prestofuoco/falling-sand/pcb/falling-sand.kicad_pcb

## KiCad design pcb/falling-sand.kicad_pcb (2026-03-06)

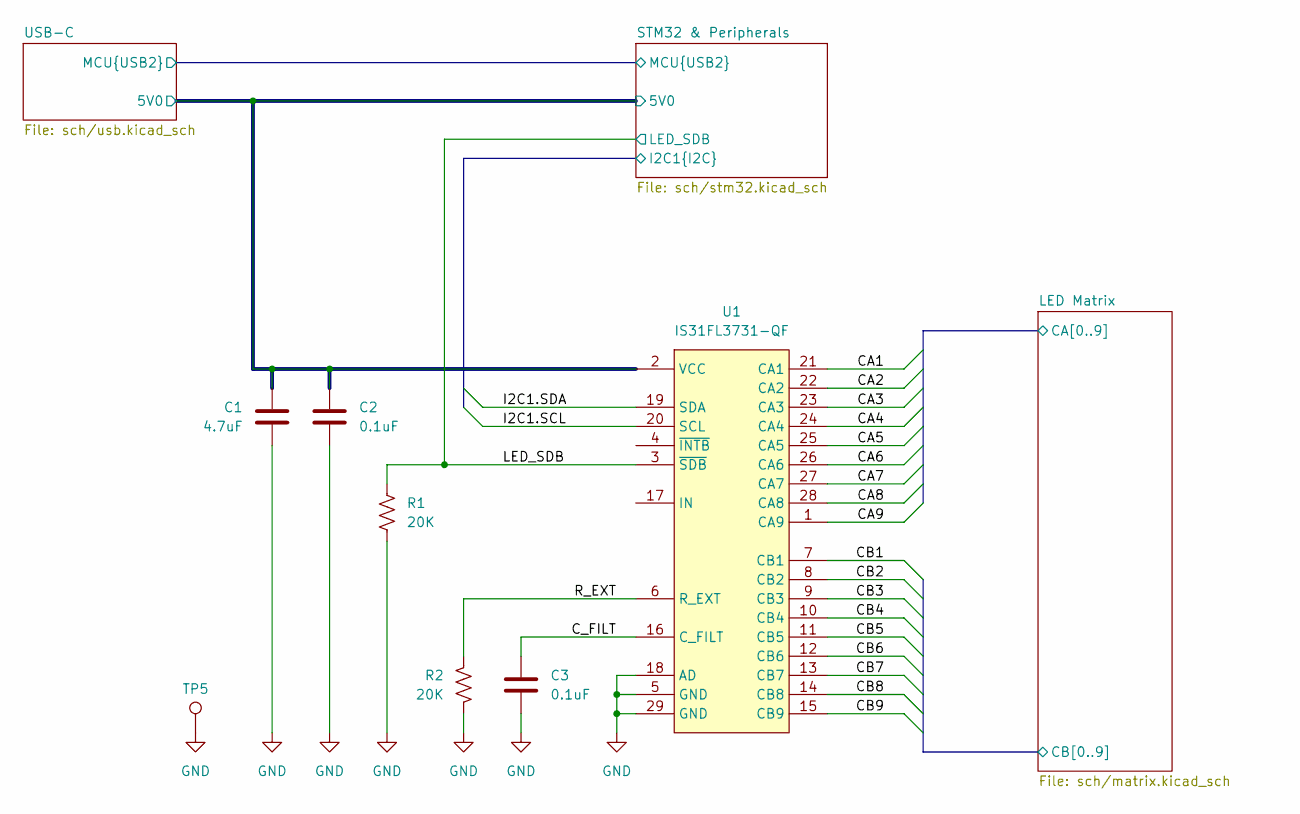
[picture p1: schematic falling-sand.kicad_sch]

Parts:
C1: 4.7uF; C_0603_1608Metric
C2, C3: 0.1uF; C_0402_1005Metric
R1, R2: 20K; R_0402_1005Metric
TP5: TestPoint; TestPoint_Pad_D1.0mm
U1: IS31FL3731-QF; QFN-28-1EP_4x4mm_P0.4mm_EP2.4x2.4mm

Connections:
/C_FILT: C3.1, U1.16 (C_FILT)
/LED Matrix/CA1: U1.21 (CA1); also elsewhere on the board
/LED Matrix/CA2: U1.22 (CA2); also elsewhere on the board
/LED Matrix/CA3: U1.23 (CA3); also elsewhere on the board
/LED Matrix/CA4: U1.24 (CA4); also elsewhere on the board
/LED Matrix/CA5: U1.25 (CA5); also elsewhere on the board
/LED Matrix/CA6: U1.26 (CA6); also elsewhere on the board
/LED Matrix/CA7: U1.27 (CA7); also elsewhere on the board
/LED Matrix/CA8: U1.28 (CA8); also elsewhere on the board
/LED Matrix/CA9: U1.1 (CA9); also elsewhere on the board
/LED Matrix/CB1: U1.7 (CB1); also elsewhere on the board
/LED Matrix/CB2: U1.8 (CB2); also elsewhere on the board
/LED Matrix/CB3: U1.9 (CB3); also elsewhere on the board
/LED Matrix/CB4: U1.10 (CB4); also elsewhere on the board
/LED Matrix/CB5: U1.11 (CB5); also elsewhere on the board
/LED Matrix/CB6: U1.12 (CB6); also elsewhere on the board
/LED Matrix/CB7: U1.13 (CB7); also elsewhere on the board
/LED Matrix/CB8: U1.14 (CB8); also elsewhere on the board
/LED Matrix/CB9: U1.15 (CB9); also elsewhere on the board
/LED_SDB: R1.1, U1.3 (~SDB); also elsewhere on the board
/R_EXT: R2.1, U1.6 (R_EXT)
/STM32 & Peripherals/5V0: C1.1, C2.1, U1.2 (VCC); also elsewhere on the board
/STM32 & Peripherals/I2C1.SCL: U1.20 (SCL); also elsewhere on the board
/STM32 & Peripherals/I2C1.SDA: U1.19 (SDA); also elsewhere on the board
GND: C1.2, C2.2, C3.2, R1.2, R2.2, TP5.1 (1_1), U1.5 (GND), U1.18 (AD), U1.29 (GND); also elsewhere on the board

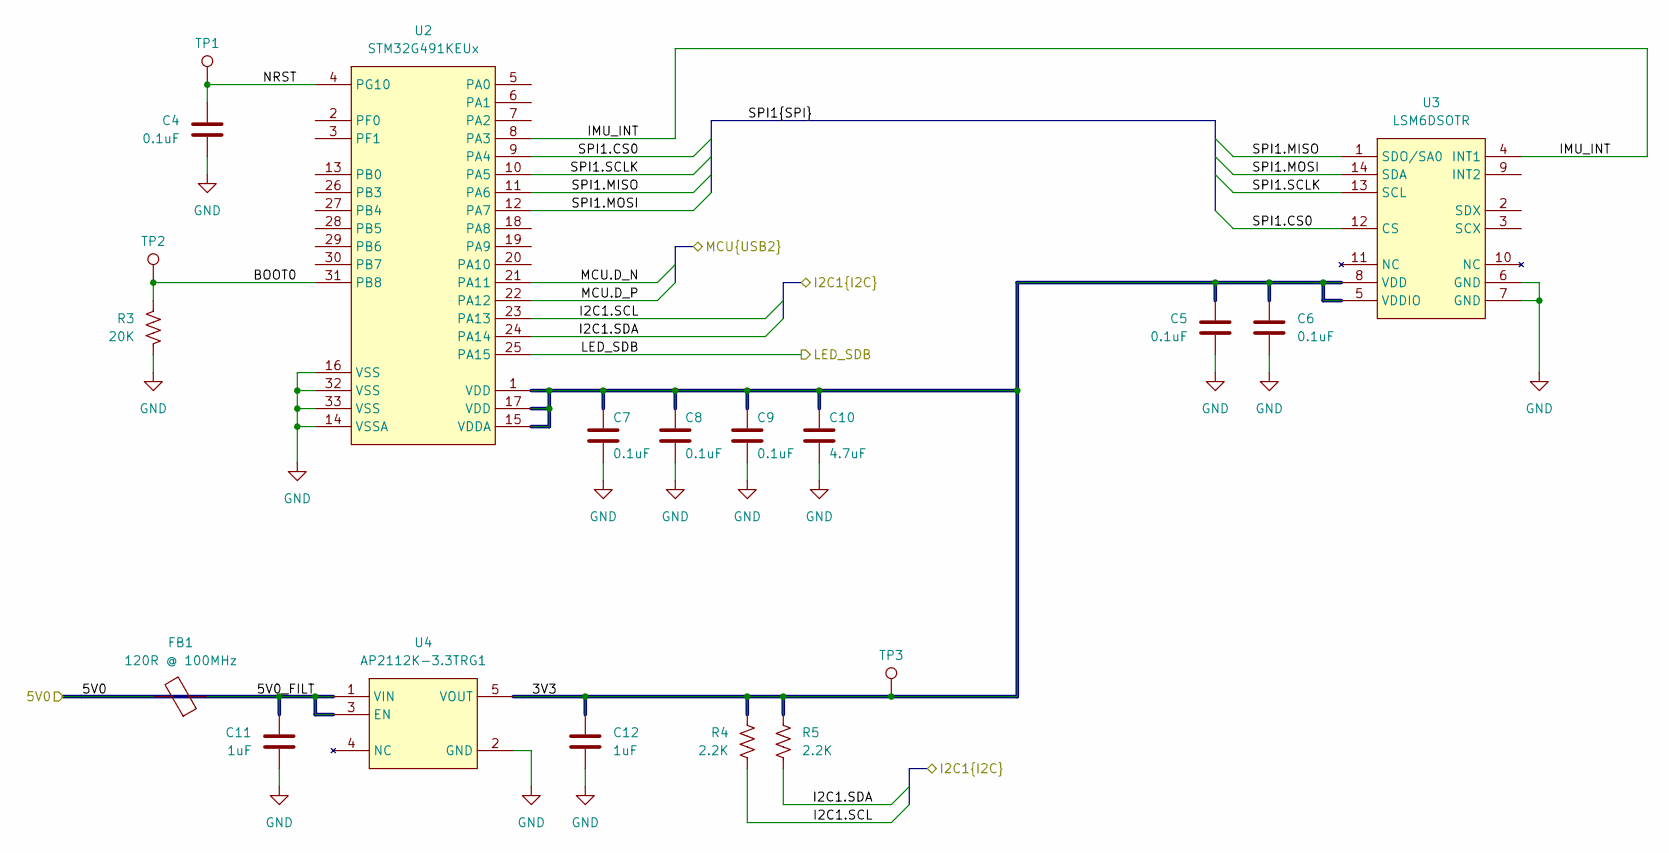
[picture p2: schematic stm32.kicad_sch]

Parts:
C4, C5, C6, C7, C8, C9: 0.1uF; C_0402_1005Metric
C10: 4.7uF; C_0603_1608Metric
C11, C12: 1uF; C_0603_1608Metric
FB1: 120R @ 100MHz; L_0805_2012Metric
R3: 20K; R_0402_1005Metric
R4, R5: 2.2K; R_0402_1005Metric
TP1, TP2, TP3: TestPoint; TestPoint_Pad_D1.0mm
U2: STM32G491KEUx; QFN-32-1EP_5x5mm_P0.5mm_EP3.45x3.45mm
U3: LSM6DSOTR; LGA-14_3x2.5mm_P0.5mm_LayoutBorder3x4y
U4: AP2112K-3.3TRG1; SOT-23-5

Connections:
/LED_SDB: U2.25 (PA15); also elsewhere on the board
/STM32 & Peripherals/3V3: C5.1, C6.1, C7.1, C8.1, C9.1, C10.1, C12.1, R4.1, R5.1, TP3.1 (1_1), U2.1 (VDD), U2.15 (VDDA), U2.17 (VDD), U3.5 (VDDIO), U3.8 (VDD), U4.5 (VOUT)
/STM32 & Peripherals/5V0: FB1.2; also elsewhere on the board
/STM32 & Peripherals/5V0_FILT: C11.1, FB1.1, U4.1 (VIN), U4.3 (EN)
/STM32 & Peripherals/BOOT0: R3.1, TP2.1 (1_1), U2.31 (PB8)
/STM32 & Peripherals/I2C1.SCL: R4.2, U2.23 (PA13); also elsewhere on the board
/STM32 & Peripherals/I2C1.SDA: R5.2, U2.24 (PA14); also elsewhere on the board
/STM32 & Peripherals/IMU_INT: U2.8 (PA3), U3.4 (INT1)
/STM32 & Peripherals/MCU.D_N: U2.21 (PA11); also elsewhere on the board
/STM32 & Peripherals/MCU.D_P: U2.22 (PA12); also elsewhere on the board
/STM32 & Peripherals/NRST: C4.1, TP1.1 (1_1), U2.4 (PG10)
/STM32 & Peripherals/SPI1.CS0: U2.9 (PA4), U3.12 (CS)
/STM32 & Peripherals/SPI1.MISO: U2.11 (PA6), U3.1 (SDO/SA0)
/STM32 & Peripherals/SPI1.MOSI: U2.12 (PA7), U3.14 (SDA)
/STM32 & Peripherals/SPI1.SCLK: U2.10 (PA5), U3.13 (SCL)
GND: C4.2, C5.2, C6.2, C7.2, C8.2, C9.2, C10.2, C11.2, C12.2, R3.2, U2.14 (VSSA), U2.16 (VSS), U2.32 (VSS), U2.33 (VSS), U3.6 (GND), U3.7 (GND), U4.2 (GND); also elsewhere on the board

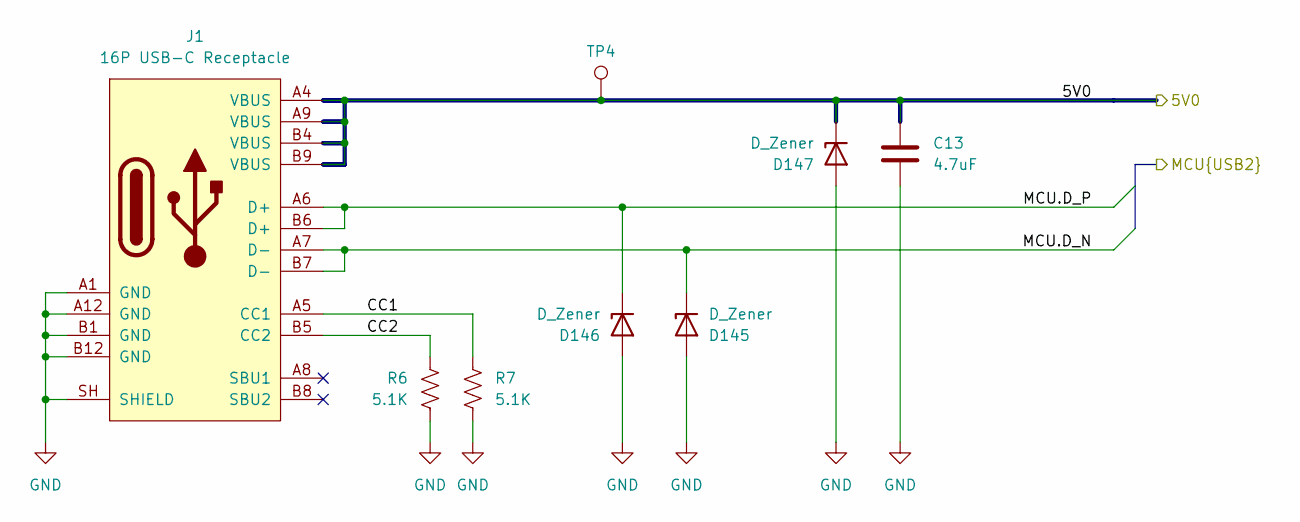
[picture p3: schematic usb.kicad_sch]

Parts:
C13: 4.7uF; C_0603_1608Metric
D145, D146, D147: D_Zener; D_SOD-882
J1: 16P USB-C Receptacle; USB_C_Receptacle_GCT_USB4105-xx-A_16P_TopMnt_Horizontal
R6, R7: 5.1K; R_0402_1005Metric
TP4: TestPoint; TestPoint_Pad_D1.0mm

Connections:
/STM32 & Peripherals/5V0: C13.1, D147.1 (K), J1.A4 (VBUS), J1.A9 (VBUS), J1.B4 (VBUS), J1.B9 (VBUS), TP4.1 (1_1); also elsewhere on the board
/STM32 & Peripherals/MCU.D_N: D145.1 (K), J1.A7 (D-), J1.B7 (D-); also elsewhere on the board
/STM32 & Peripherals/MCU.D_P: D146.1 (K), J1.A6 (D+), J1.B6 (D+); also elsewhere on the board
/USB-C/CC1: J1.A5 (CC1), R7.1
/USB-C/CC2: J1.B5 (CC2), R6.1
GND: C13.2, D145.2 (A), D146.2 (A), D147.2 (A), J1.A1 (GND), J1.A12 (GND), J1.B1 (GND), J1.B12 (GND), J1.SH (SHIELD), R6.2, R7.2; also elsewhere on the board

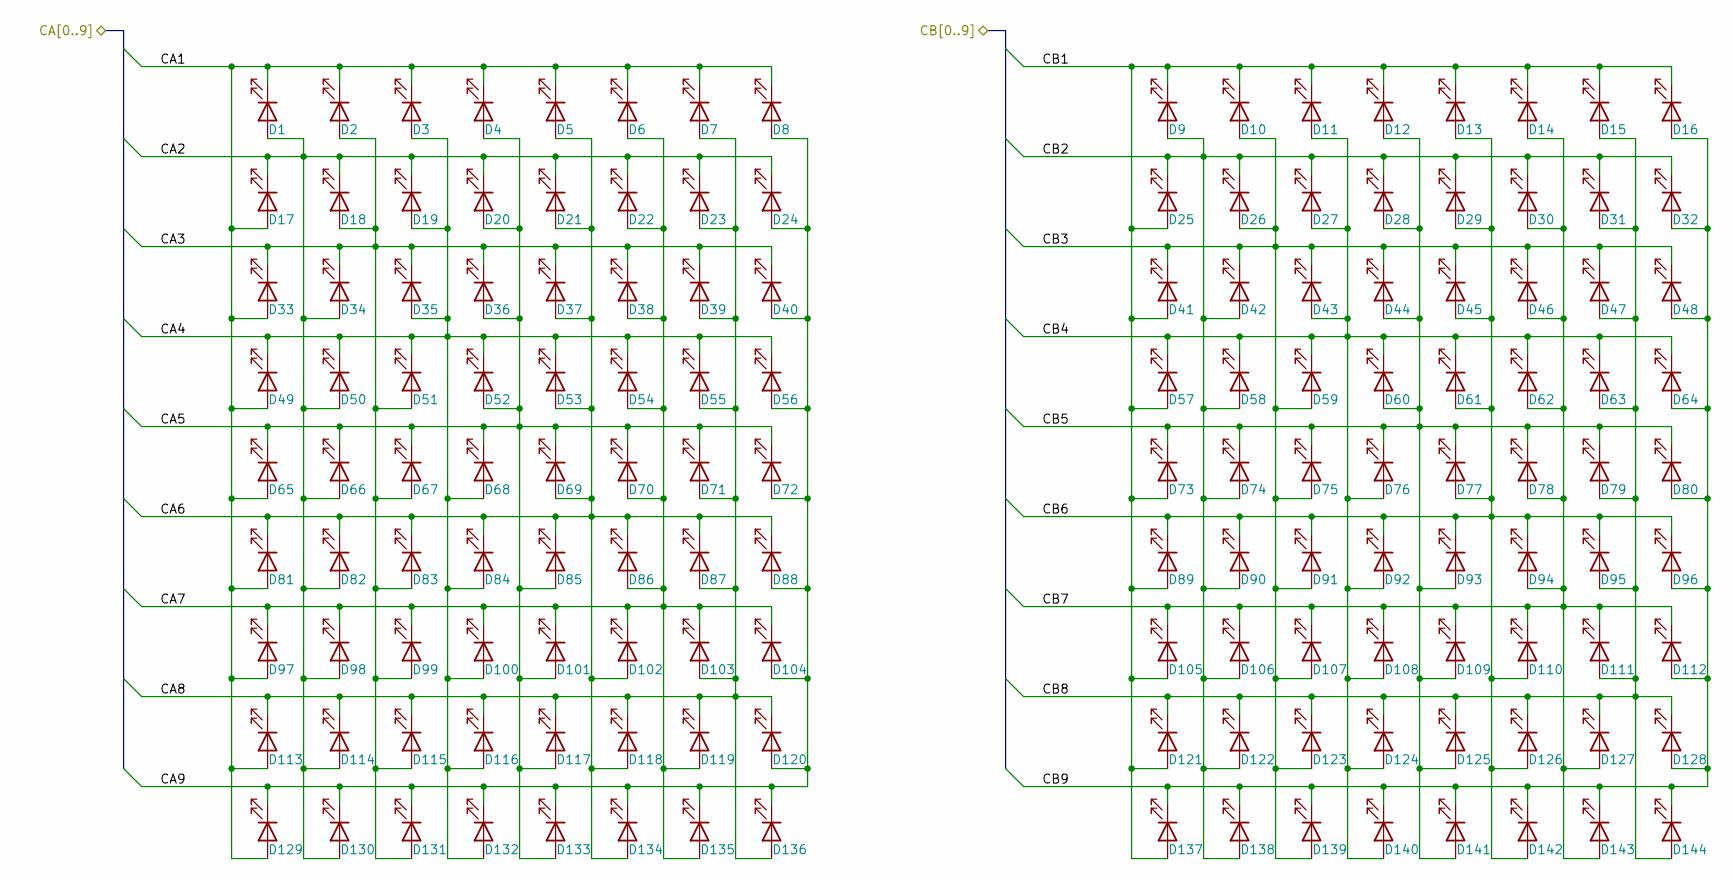
[picture p4: schematic matrix.kicad_sch]

Parts:
D1, D2, D3, D4, D5, D6, D7, D8, D9, D10, D11, D12, D13, D14, D15, D16, D17, D18, D19, D20, D21, D22, D23, D24, D25, D26, D27, D28, D29, D30, D31, D32, D33, D34, D35, D36, D37, D38, D39, D40, D41, D42, D43, D44, D45, D46, D47, D48, D49, D50, D51, D52, D53, D54, D55, D56, D57, D58, D59, D60, D61, D62, D63, D64, D65, D66, D67, D68, D69, D70, D71, D72, D73, D74, D75, D76, D77, D78, D79, D80, D81, D82, D83, D84, D85, D86, D87, D88, D89, D90, D91, D92, D93, D94, D95, D96, D97, D98, D99, D100, D101, D102, D103, D104, D105, D106, D107, D108, D109, D110, D111, D112, D113, D114, D115, D116, D117, D118, D119, D120, D121, D122, D123, D124, D125, D126, D127, D128, D129, D130, D131, D132, D133, D134, D135, D136, D137, D138, D139, D140, D141, D142, D143, D144: LED; LED_0402_1005Metric

Connections:
/LED Matrix/CA1: D1.1 (K), D2.1 (K), D3.1 (K), D4.1 (K), D5.1 (K), D6.1 (K), D7.1 (K), D8.1 (K), D17.2 (A), D33.2 (A), D49.2 (A), D65.2 (A), D81.2 (A), D97.2 (A), D113.2 (A), D129.2 (A); also elsewhere on the board
/LED Matrix/CA2: D1.2 (A), D17.1 (K), D18.1 (K), D19.1 (K), D20.1 (K), D21.1 (K), D22.1 (K), D23.1 (K), D24.1 (K), D34.2 (A), D50.2 (A), D66.2 (A), D82.2 (A), D98.2 (A), D114.2 (A), D130.2 (A); also elsewhere on the board
/LED Matrix/CA3: D2.2 (A), D18.2 (A), D33.1 (K), D34.1 (K), D35.1 (K), D36.1 (K), D37.1 (K), D38.1 (K), D39.1 (K), D40.1 (K), D51.2 (A), D67.2 (A), D83.2 (A), D99.2 (A), D115.2 (A), D131.2 (A); also elsewhere on the board
/LED Matrix/CA4: D3.2 (A), D19.2 (A), D35.2 (A), D49.1 (K), D50.1 (K), D51.1 (K), D52.1 (K), D53.1 (K), D54.1 (K), D55.1 (K), D56.1 (K), D68.2 (A), D84.2 (A), D100.2 (A), D116.2 (A), D132.2 (A); also elsewhere on the board
/LED Matrix/CA5: D4.2 (A), D20.2 (A), D36.2 (A), D52.2 (A), D65.1 (K), D66.1 (K), D67.1 (K), D68.1 (K), D69.1 (K), D70.1 (K), D71.1 (K), D72.1 (K), D85.2 (A), D101.2 (A), D117.2 (A), D133.2 (A); also elsewhere on the board
/LED Matrix/CA6: D5.2 (A), D21.2 (A), D37.2 (A), D53.2 (A), D69.2 (A), D81.1 (K), D82.1 (K), D83.1 (K), D84.1 (K), D85.1 (K), D86.1 (K), D87.1 (K), D88.1 (K), D102.2 (A), D118.2 (A), D134.2 (A); also elsewhere on the board
/LED Matrix/CA7: D6.2 (A), D22.2 (A), D38.2 (A), D54.2 (A), D70.2 (A), D86.2 (A), D97.1 (K), D98.1 (K), D99.1 (K), D100.1 (K), D101.1 (K), D102.1 (K), D103.1 (K), D104.1 (K), D119.2 (A), D135.2 (A); also elsewhere on the board
/LED Matrix/CA8: D7.2 (A), D23.2 (A), D39.2 (A), D55.2 (A), D71.2 (A), D87.2 (A), D103.2 (A), D113.1 (K), D114.1 (K), D115.1 (K), D116.1 (K), D117.1 (K), D118.1 (K), D119.1 (K), D120.1 (K), D136.2 (A); also elsewhere on the board
/LED Matrix/CA9: D8.2 (A), D24.2 (A), D40.2 (A), D56.2 (A), D72.2 (A), D88.2 (A), D104.2 (A), D120.2 (A), D129.1 (K), D130.1 (K), D131.1 (K), D132.1 (K), D133.1 (K), D134.1 (K), D135.1 (K), D136.1 (K); also elsewhere on the board
/LED Matrix/CB1: D9.1 (K), D10.1 (K), D11.1 (K), D12.1 (K), D13.1 (K), D14.1 (K), D15.1 (K), D16.1 (K), D25.2 (A), D41.2 (A), D57.2 (A), D73.2 (A), D89.2 (A), D105.2 (A), D121.2 (A), D137.2 (A); also elsewhere on the board
/LED Matrix/CB2: D9.2 (A), D25.1 (K), D26.1 (K), D27.1 (K), D28.1 (K), D29.1 (K), D30.1 (K), D31.1 (K), D32.1 (K), D42.2 (A), D58.2 (A), D74.2 (A), D90.2 (A), D106.2 (A), D122.2 (A), D138.2 (A); also elsewhere on the board
/LED Matrix/CB3: D10.2 (A), D26.2 (A), D41.1 (K), D42.1 (K), D43.1 (K), D44.1 (K), D45.1 (K), D46.1 (K), D47.1 (K), D48.1 (K), D59.2 (A), D75.2 (A), D91.2 (A), D107.2 (A), D123.2 (A), D139.2 (A); also elsewhere on the board
/LED Matrix/CB4: D11.2 (A), D27.2 (A), D43.2 (A), D57.1 (K), D58.1 (K), D59.1 (K), D60.1 (K), D61.1 (K), D62.1 (K), D63.1 (K), D64.1 (K), D76.2 (A), D92.2 (A), D108.2 (A), D124.2 (A), D140.2 (A); also elsewhere on the board
/LED Matrix/CB5: D12.2 (A), D28.2 (A), D44.2 (A), D60.2 (A), D73.1 (K), D74.1 (K), D75.1 (K), D76.1 (K), D77.1 (K), D78.1 (K), D79.1 (K), D80.1 (K), D93.2 (A), D109.2 (A), D125.2 (A), D141.2 (A); also elsewhere on the board
/LED Matrix/CB6: D13.2 (A), D29.2 (A), D45.2 (A), D61.2 (A), D77.2 (A), D89.1 (K), D90.1 (K), D91.1 (K), D92.1 (K), D93.1 (K), D94.1 (K), D95.1 (K), D96.1 (K), D110.2 (A), D126.2 (A), D142.2 (A); also elsewhere on the board
/LED Matrix/CB7: D14.2 (A), D30.2 (A), D46.2 (A), D62.2 (A), D78.2 (A), D94.2 (A), D105.1 (K), D106.1 (K), D107.1 (K), D108.1 (K), D109.1 (K), D110.1 (K), D111.1 (K), D112.1 (K), D127.2 (A), D143.2 (A); also elsewhere on the board
/LED Matrix/CB8: D15.2 (A), D31.2 (A), D47.2 (A), D63.2 (A), D79.2 (A), D95.2 (A), D111.2 (A), D121.1 (K), D122.1 (K), D123.1 (K), D124.1 (K), D125.1 (K), D126.1 (K), D127.1 (K), D128.1 (K), D144.2 (A); also elsewhere on the board
/LED Matrix/CB9: D16.2 (A), D32.2 (A), D48.2 (A), D64.2 (A), D80.2 (A), D96.2 (A), D112.2 (A), D128.2 (A), D137.1 (K), D138.1 (K), D139.1 (K), D140.1 (K), D141.1 (K), D142.1 (K), D143.1 (K), D144.1 (K); also elsewhere on the board

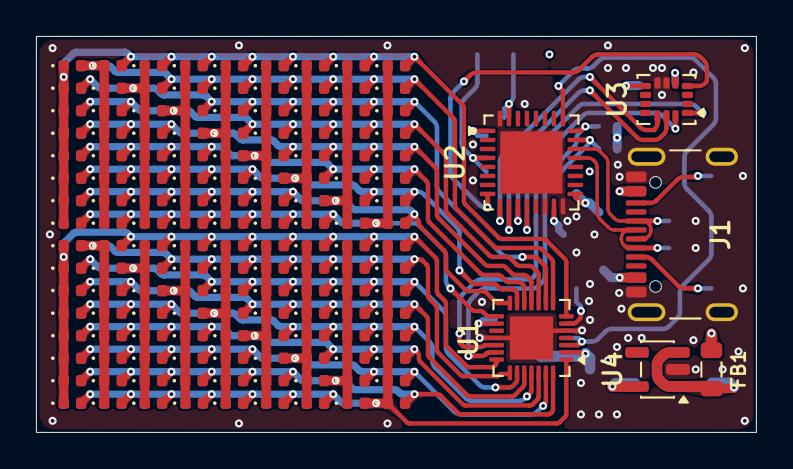
[picture p5: board falling-sand.kicad_pcb from above]

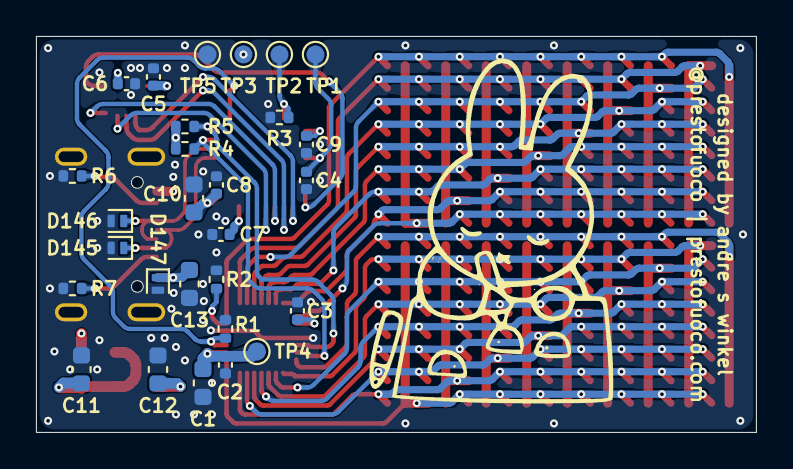
[picture p6: board falling-sand.kicad_pcb from below]

Board: 4 copper layers, 40.0 x 22.0 mm, 178 parts (28 on the bottom side), 38 nets.
