prestofuoco/falling-sand/src/src.ioc

Mcu.UserName=STM32G491KEUx
PA11.Signal=USB_DM
PA12.Signal=USB_DP
PA13.Signal=I2C1_SCL
PA14.Signal=I2C1_SDA
PA15.GPIO_Label=LED_SDB
PA15.Signal=GPIO_Output
PA3.GPIO_Label=IMU_INT
PA3.Signal=GPIO_Input
PA4.GPIO_Label=IMU_CS
PA4.Signal=GPIO_Output
PA5.Signal=SPI1_SCK
PA6.Signal=SPI1_MISO
PA7.Signal=SPI1_MOSI
