prestofuoco/falling-sand/(commit log)

2026-03-10 8 bit spi, lm6dso drivers
2026-03-10 init driver structure
2026-03-11 led matrix driver defined is31_init and set frame
